Aqamoe/Slide-projector/物料清单.xlsx

序号 | 名称 | 型号 | 单价 | 数量 | 总价 | 链接
1 | 投影机4.3寸高清镜头 | 4.3寸 | 15 | 1 | 15 | https://e.tb.cn/h.SDSDSBcxRtBfjG9?tk=FvbUfmIydby
2 | 7mm COB 灯珠 | 7W | 4 | 1 | 4 | https://e.tb.cn/h.Swm9ZLwIhmuF1sz?tk=E213fmIAUib
3 | 5.5cm散热器 | 5V 5.5cm | 7.5 | 1 | 7.5 | https://e.tb.cn/h.SwmPXvXxNElJ1Dn?tk=tCjMfmIAkhT
4 | PVC菲涅尔透镜 |  | 1 | 3 | 3 | https://e.tb.cn/h.SD7aRVQdthyvn1u?tk=XwrQfmsaYCH
5 | PCBA |  | 10 | 1 | 10
6 | 3D打印PETG外壳 |  | 15 | 1 | 15
7 | M3*18圆柱头螺丝 | M3*18 | 0.05 | 4 | 0.2
8 | M2*6自攻螺丝 | M2*6 | 0.02 | 14 | 0.28
9 | PH2.0端子线 | PH2.0 100MM | 0.2 | 2 | 0.4
10 | 18650电池弹簧片 | 18.5*16.5mm | 0.3 | 1 | 0.3 | https://e.tb.cn/h.SwmPXvXxNElJ1Dn?tk=tCjMfmIAkhT
11 |  |  |  |  | 55.68
12
13
14
15
16
17
18
19
20
21
22
23
24
25
26
27
28
29
