Aqamoe/Slide-projector/幻灯机主体.3mf

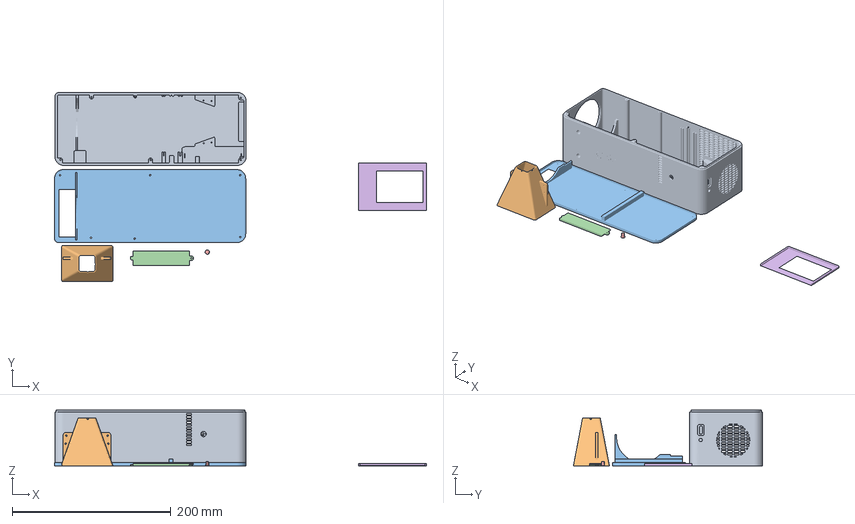
[picture p7: CAD file, 2025-12-10]
幻灯机主体.3mf
468.8 x 238.4 x 70.0 mm
底壳.STL
聚光罩.STL
顶壳.STL
电池盖.STL
按键.STL
成像校正挡板.STL
