Aqamoe/Slide-projector/幻灯机模型/STL文件/聚光罩.STL

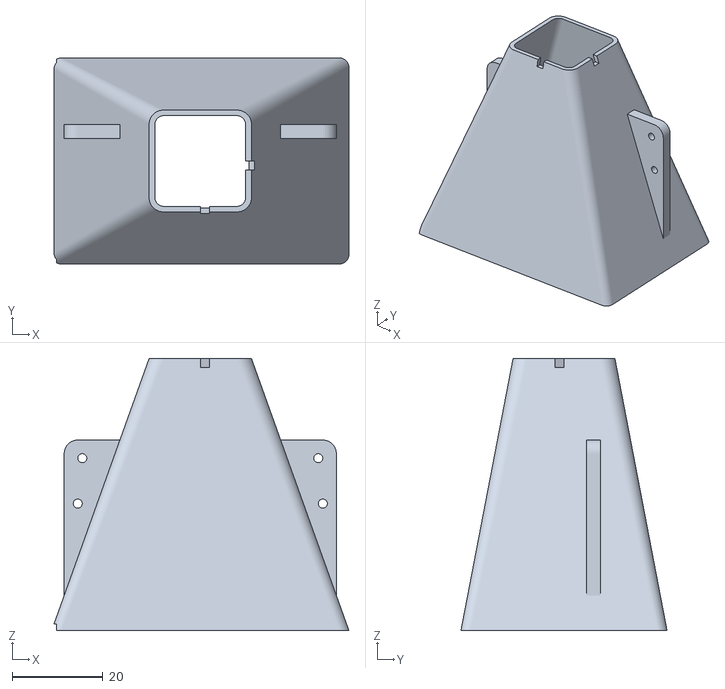
[picture p8: CAD file, 2025-12-10]
幻灯机模型/STL文件/聚光罩.STL
65.0 x 45.4 x 60.0
