Aqamoe/Slide-projector/幻灯机模型/散热风扇.SLDPRT

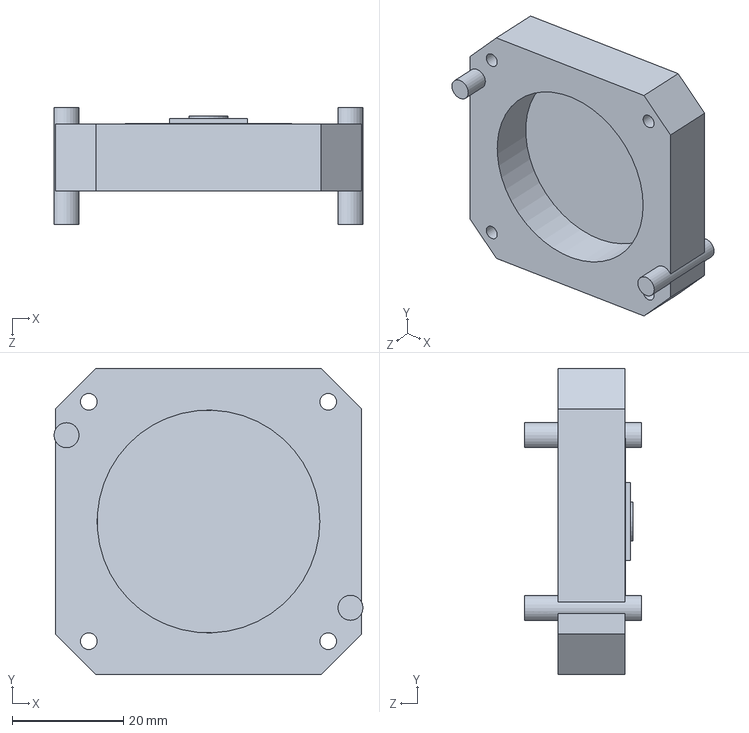
[picture p9: CAD file, 2025-12-10]
幻灯机模型/散热风扇.SLDPRT
55.5 x 55.0 x 21.0 mm
