Aqamoe/Slide-projector/幻灯机模型/STL文件/按键.STL

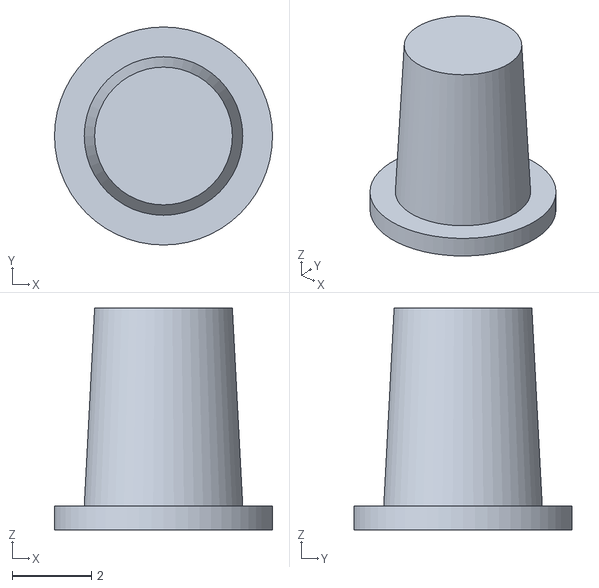
[picture p10: CAD file, 2025-12-10]
幻灯机模型/STL文件/按键.STL
5.50 x 5.50 x 5.60
