Aqamoe/Slide-projector/幻灯机模型/平凸透镜.SLDPRT

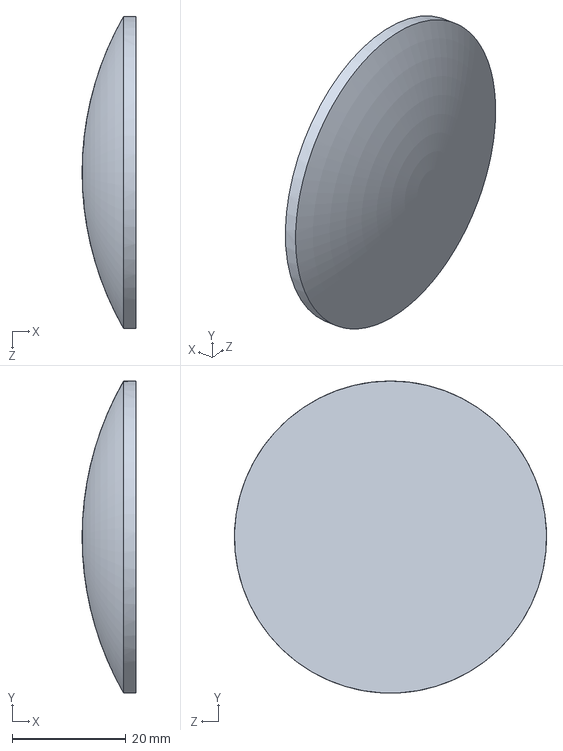
[picture p11: CAD file, 2025-12-10]
幻灯机模型/平凸透镜.SLDPRT
9.50 x 55.0 x 55.0 mm
