Aqamoe/Slide-projector/幻灯机模型/STL文件/电池盖.STL

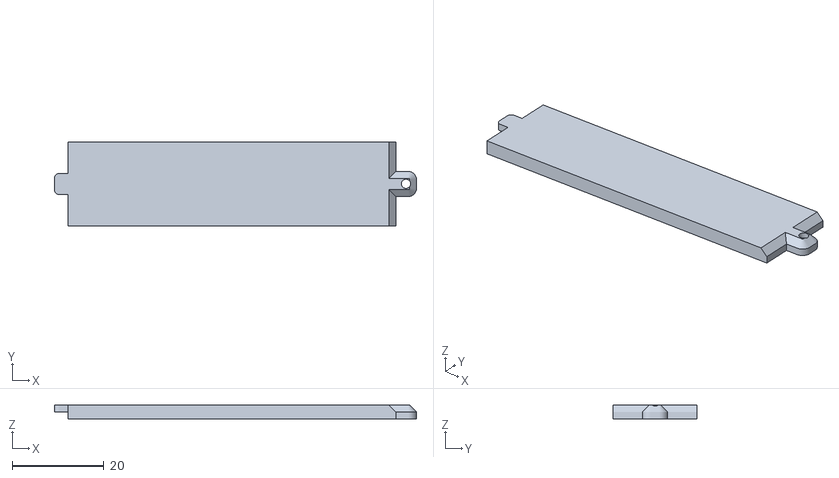
[picture p12: CAD file, 2025-12-10]
幻灯机模型/STL文件/电池盖.STL
79.1 x 18.4 x 3.00
