Aqamoe/Slide-projector/幻灯机模型/投影镜头.SLDPRT

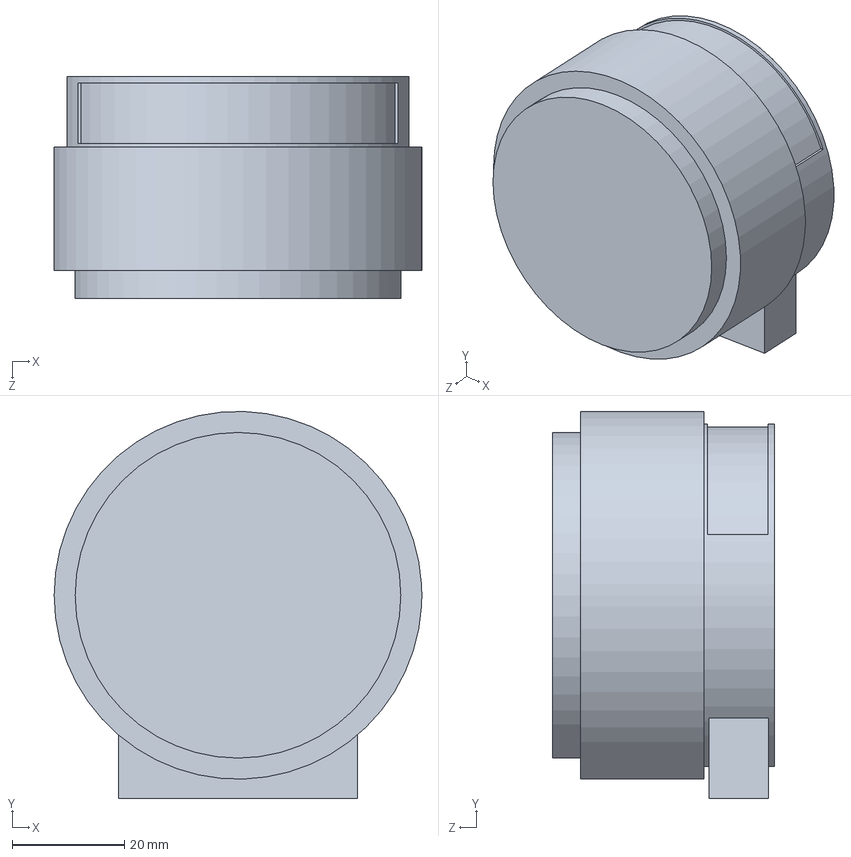
[picture p13: CAD file, 2025-12-10]
幻灯机模型/投影镜头.SLDPRT
65.5 x 68.9 x 39.6 mm
