Aqamoe/Slide-projector/幻灯机模型/STL文件/顶壳.STL

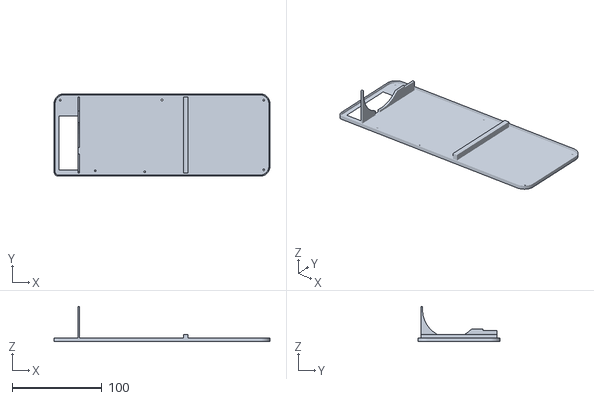
[picture p14: CAD file, 2025-12-10]
幻灯机模型/STL文件/顶壳.STL
241.0 x 92.0 x 39.5
