Aqamoe/Slide-projector/幻灯机模型/STL文件/成像校正挡板.STL

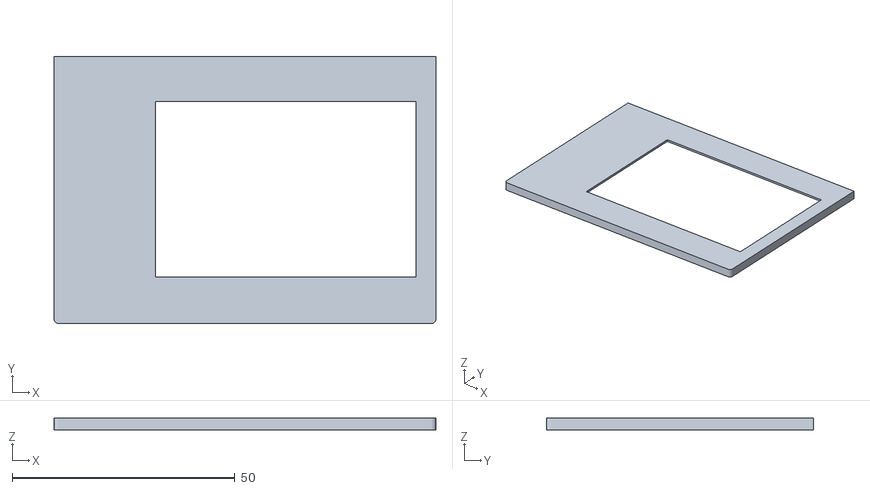
[picture p15: CAD file, 2025-12-10]
幻灯机模型/STL文件/成像校正挡板.STL
85.8 x 60.0 x 2.60
