Aqamoe/Slide-projector/幻灯机模型/STL文件/底壳.STL

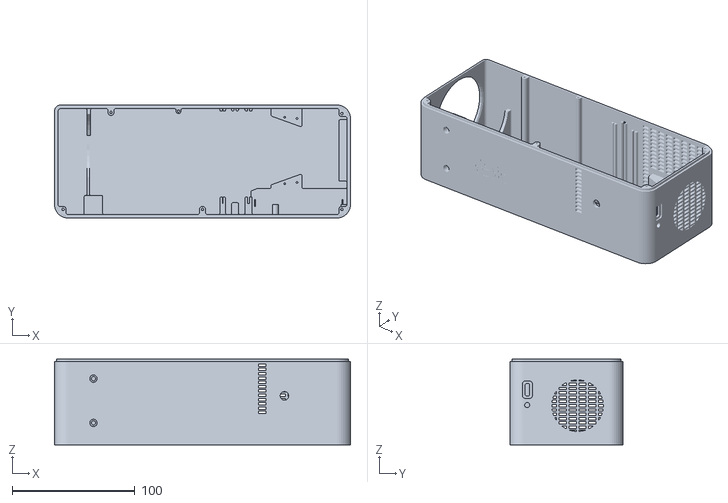
[picture p16: CAD file, 2025-12-10]
幻灯机模型/STL文件/底壳.STL
241.0 x 92.0 x 70.0
