Aqamoe/Slide-projector/幻灯机模型/底壳.SLDPRT

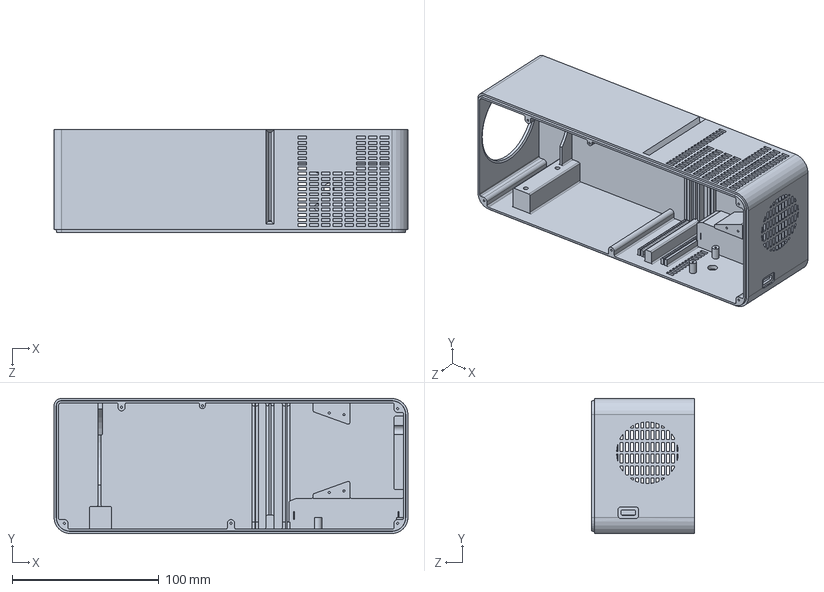
[picture p17: CAD file, 2025-12-10]
幻灯机模型/底壳.SLDPRT
241.0 x 92.0 x 70.0 mm
