Aqamoe/Slide-projector/幻灯机模型/菲涅尔透镜.SLDPRT

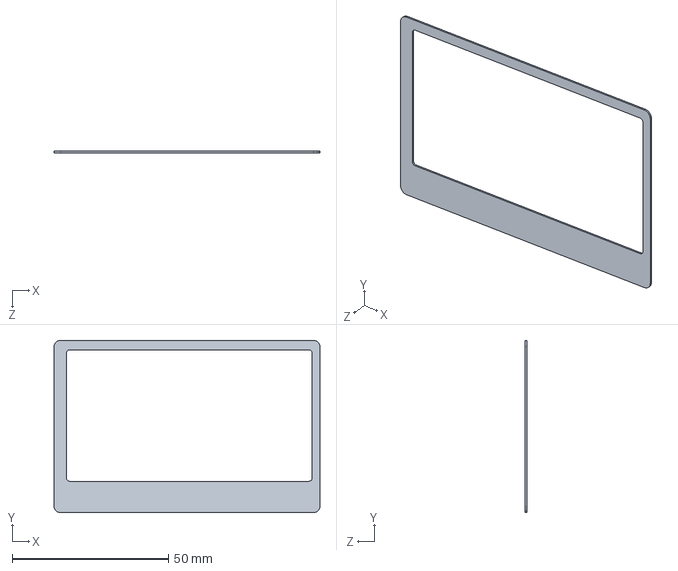
[picture p18: CAD file, 2025-12-10]
幻灯机模型/菲涅尔透镜.SLDPRT
85.0 x 55.0 x 0.5 mm
