Aqamoe/Slide-projector/幻灯机模型/幻灯片.SLDPRT

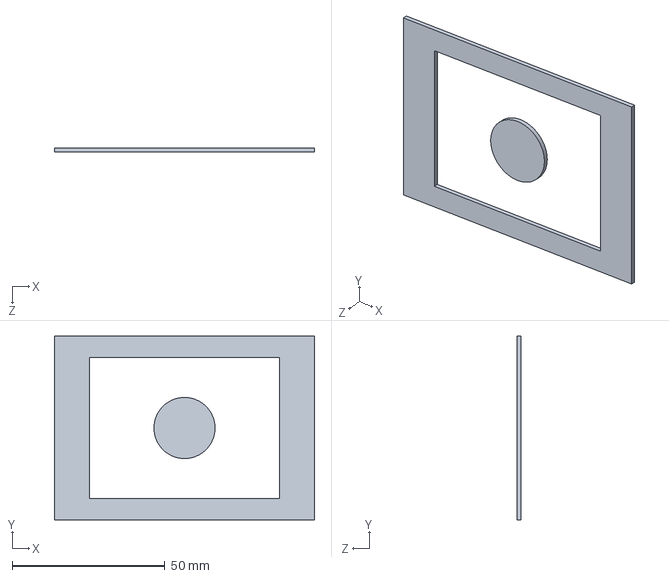
[picture p19: CAD file, 2025-12-10]
幻灯机模型/幻灯片.SLDPRT
85.0 x 60.0 x 1.40 mm
