Aqamoe/Slide-projector/(list of files, cad)

Other CAD files:
幻灯机模型/顶壳.SLDPRT
幻灯机模型/聚光罩.SLDPRT
幻灯机模型/成像校正挡板.SLDPRT
幻灯机模型/电池盖.SLDPRT
幻灯机模型/按键.SLDPRT
幻灯机模型/18650.sldprt
