Aqamoe/Slide-projector/PCBA/幻灯机控制板原理图.pdf

LED驱动电路 | PWM生成及调节电路

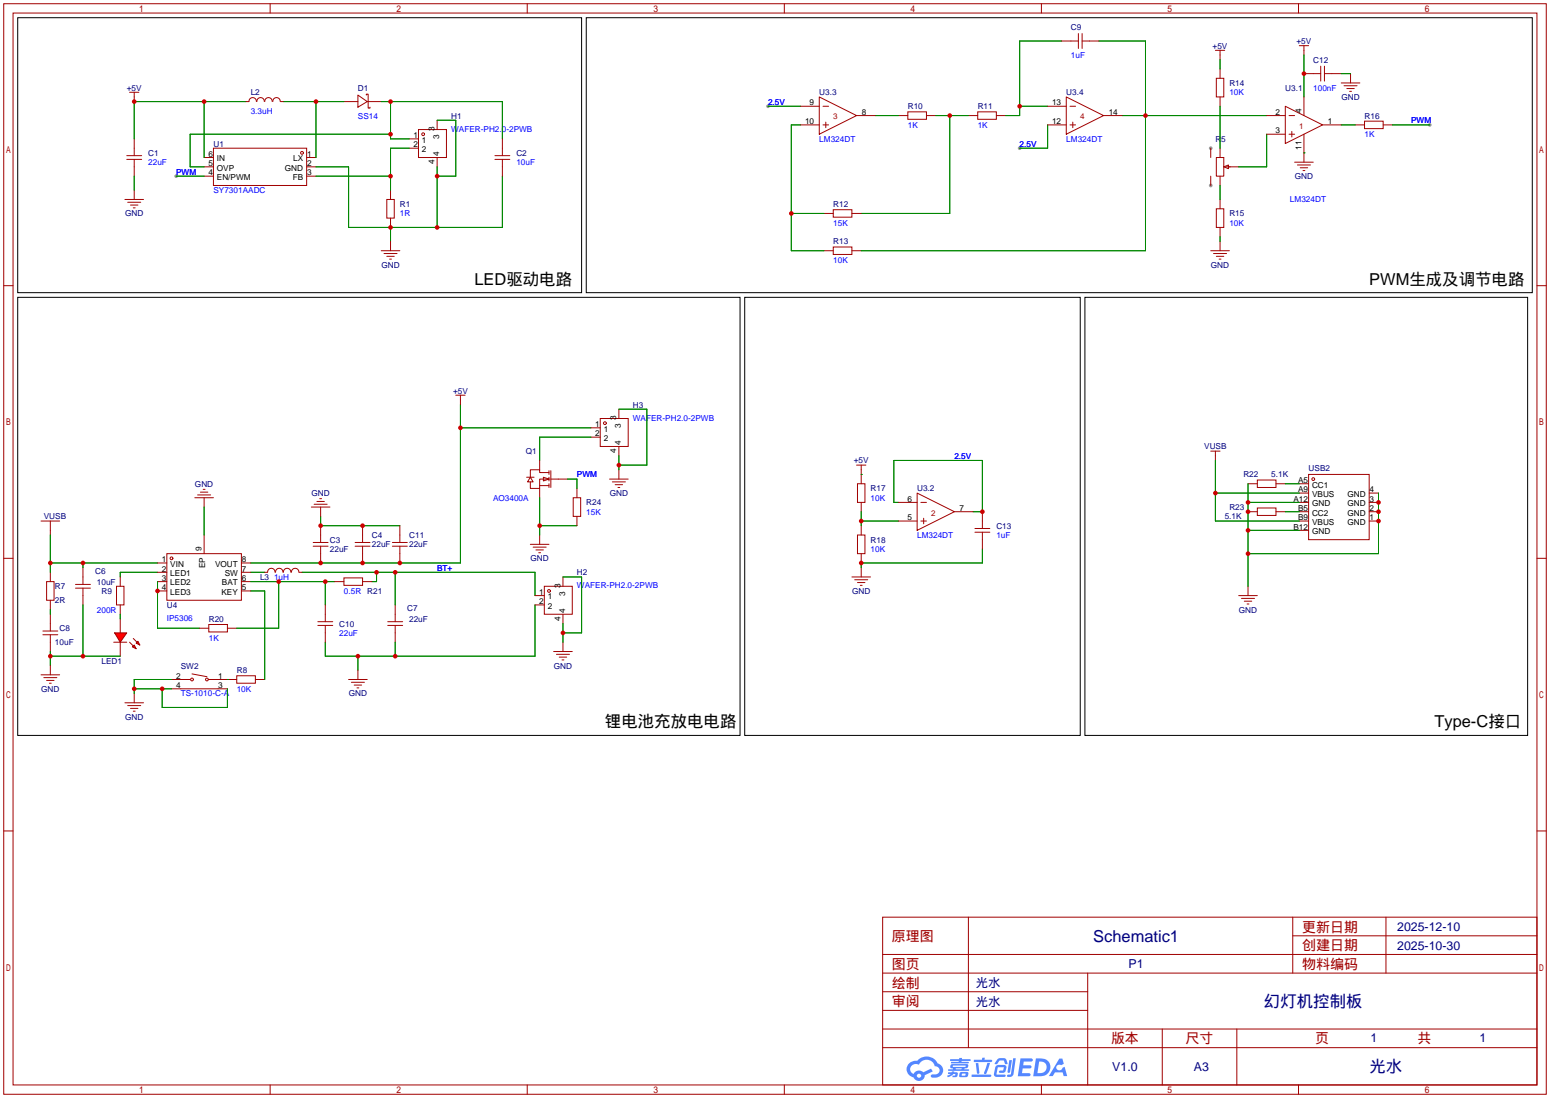
[picture p20: page 1]
