Aqamoe/Slide-projector/(list of files, drawings)

Other design files:
PCBA/ProPrj_幻灯机控制板_2025-12-10.epro
