Aqamoe/Slide-projector/(commit log)

2025-12-10 首次提交：上传文件
    [18650.sldprt, 平凸透镜.SLDPRT, 幻灯机主体.3mf, 幻灯片.SLDPRT, 底壳.SLDPRT, 底壳.STL, 成像校正挡板.SLDPRT, 成像校正挡板.STL]
2025-12-10 add: 添加PCBA文件
    [ProPrj_幻灯机控制板_2025-12-10.epro]
2025-12-10 update: 更新安装步骤
